Daft-Freak/32blit-hardware/pcb/kicad/LCDs_and_Power.kicad_sch

## KiCad design pcb/kicad/LCDs_and_Power.kicad_sch (2023-02-24)

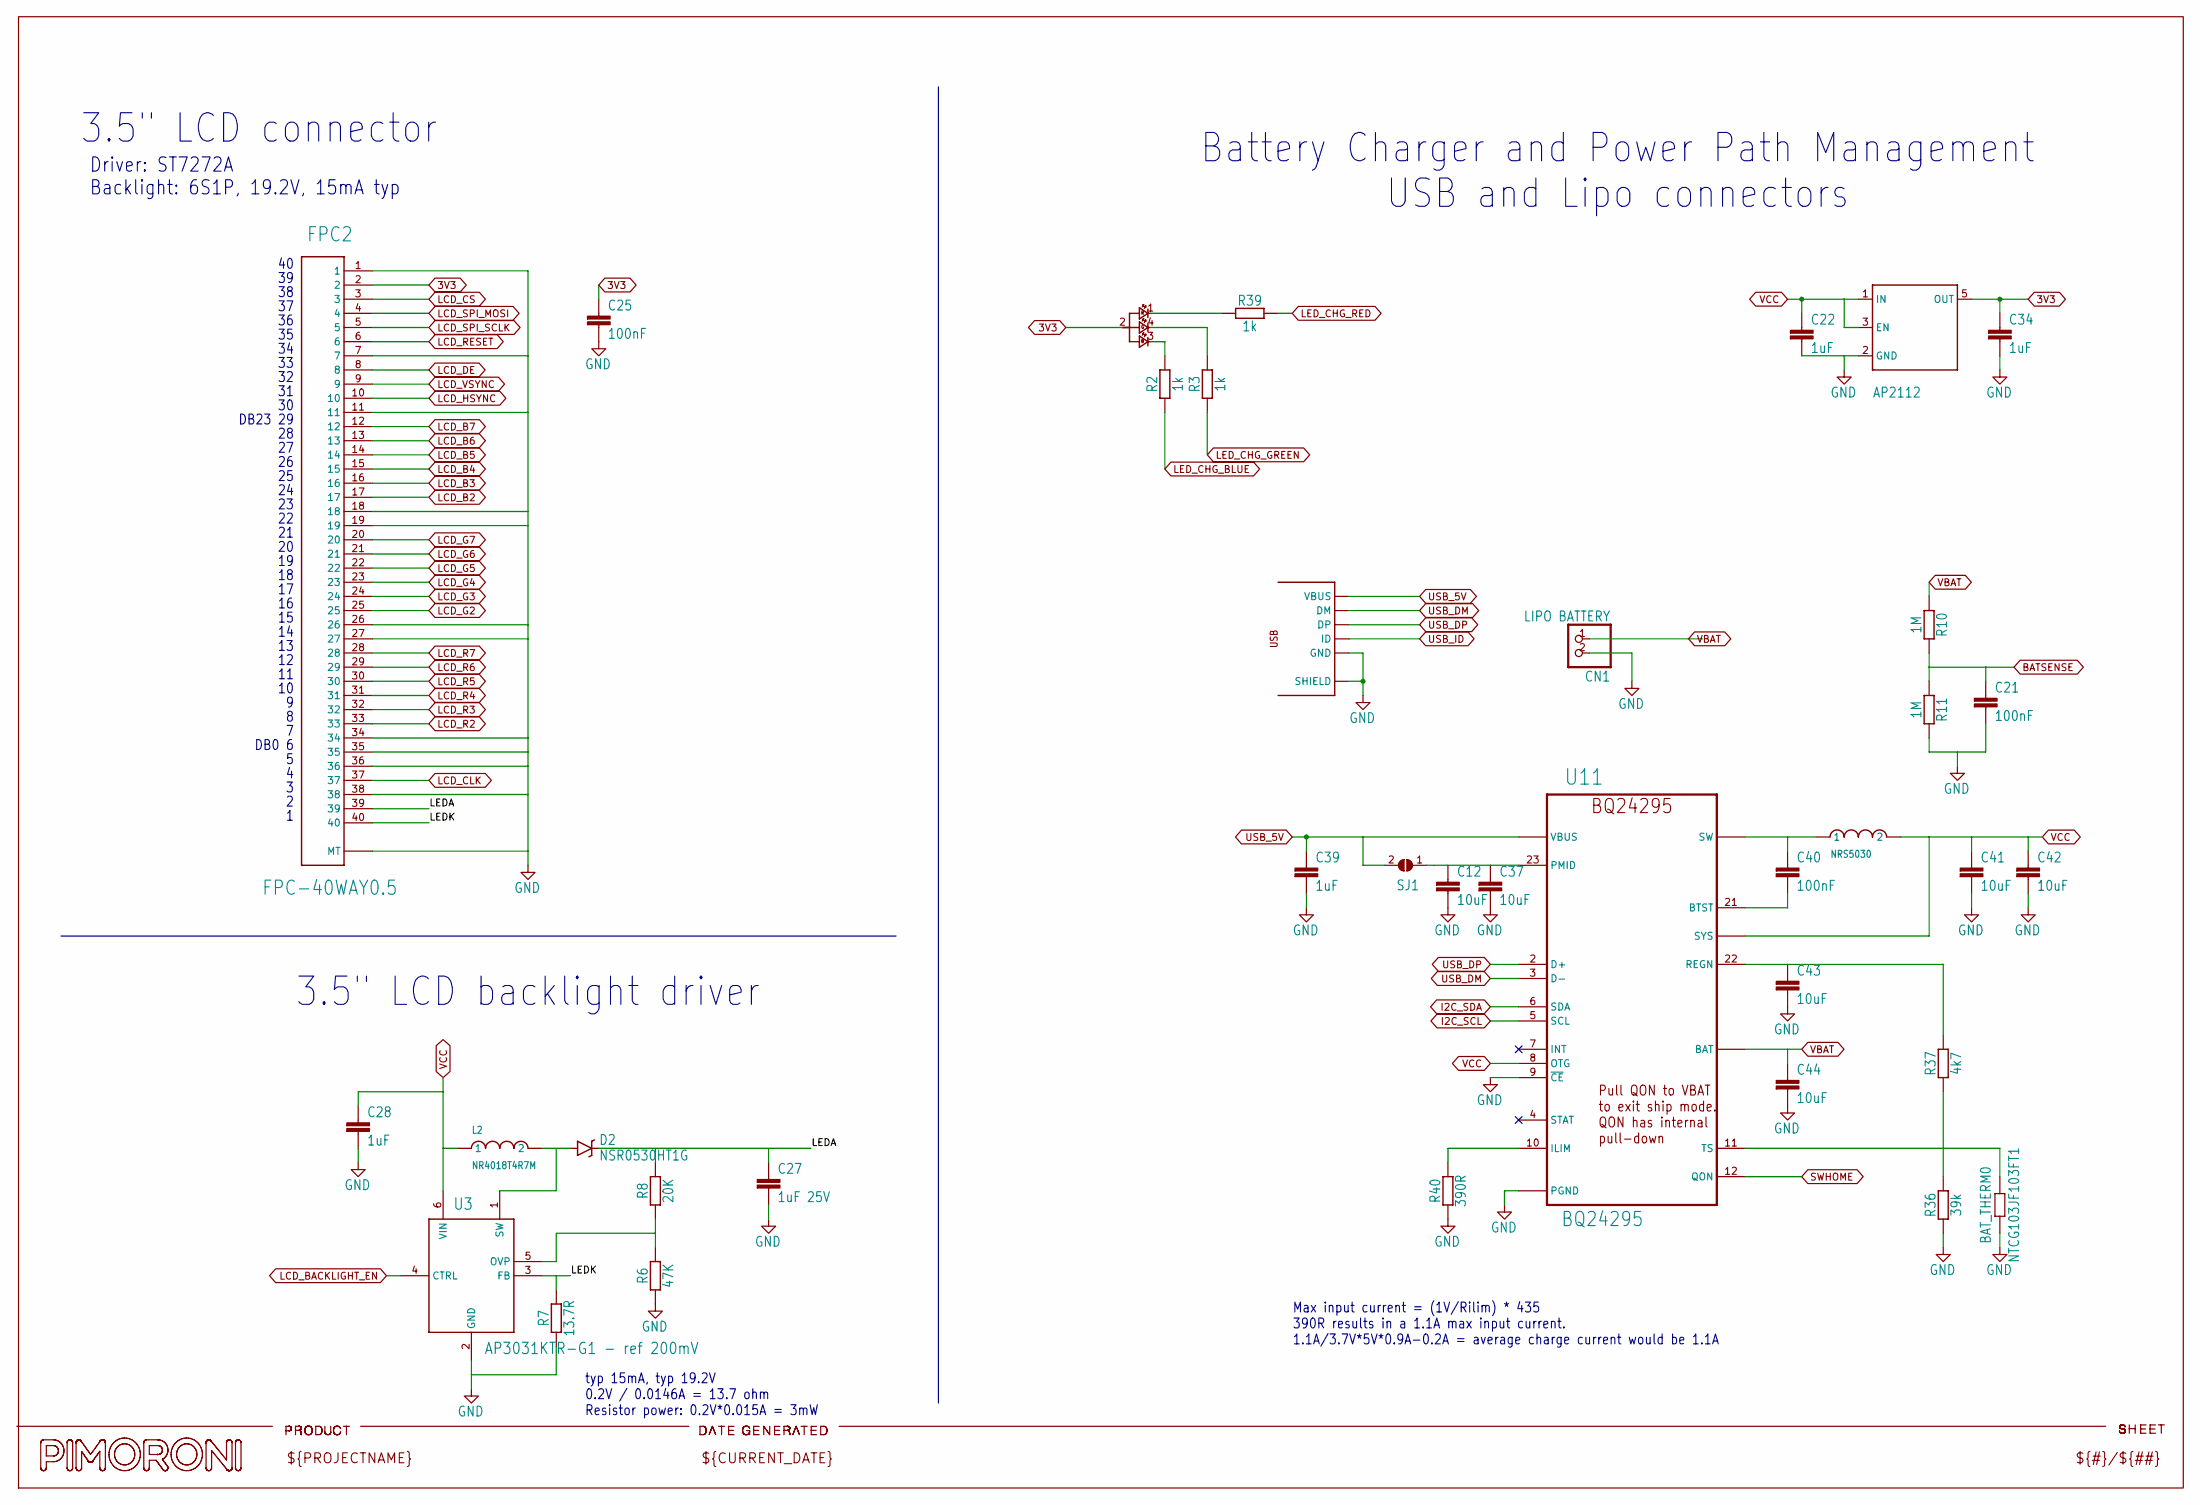
[picture p1: schematic LCDs_and_Power.kicad_sch]

Parts:
BAT_THERM0: NTCG103JF103FT1; 0402@1
C12, C37, C41, C42, C43, C44: 10uF; C0805
C21, C25, C40: 100nF; C0402K
C22, C28, C34, C39: 1uF; C0603
C27: 1uF 25V; C0603
CN1: LIPO BATTERY; JST-PH-2-SMT-RA
D2: NSR0530HT1G
FPC2: FPC-40WAY0.5; FPC-0.5MM-40WAY
L1: NRS5030
L2: NR4018T4R7M; NR4018
R2, R3, R39: 1k; R0603
R6: 47K; R0603
R7: 13.7R; R0603
R8: 20K; R0603
R10, R11: 1M; R0603
R36: 39k; R0603
R37: 4k7; R0603
R40: 390R; R0603
RGB1: LED_RGB_4P6028_REVERSE; LED-6028_REVERSE_RGB
SJ1: SOLDERJUMPER; SOLDERJUMPER_ARROW_NOPASTE
U3: AP3031KTR-G1 - ref 200mV; SOT23-6L
U6: AP2112; SOT-23-5
U11: BQ24295; QFN50P400X400X100-25N
U$3: USBMICROB; MICROB-USB

Connections:
3V3: C25.1, C34.1, FPC2.2, RGB1.2 (A), U6.5 (OUT)
BATSENSE: C21.1, R10.2, R11.1
GND: BAT_THERM0.1, C12.2, C21.2, C22.2, C25.2, C27.2, C28.2, C34.2, C37.2, C39.2, C41.2, C42.2, C43.2, C44.2, CN1.2 (1), FPC2.1, FPC2.7, FPC2.11, FPC2.18, FPC2.19, FPC2.26, FPC2.27, FPC2.34, FPC2.35, FPC2.36, FPC2.38, FPC2.MT1 (MT), FPC2.MT2 (MT), R6.1, R7.1, R11.2, R36.1, R40.1, U3.2 (GND), U6.2 (GND), U11.9 (~CE), U11.17 (PGND), U11.18 (PGND), U11.25 (PGND), U$3.GND, U$3.SH1 (SHIELD), U$3.SH2 (SHIELD), U$3.SH3 (SHIELD), U$3.SH4 (SHIELD), U$3.SH5 (SHIELD), U$3.SH6 (SHIELD), U$3.SH7 (SHIELD), U$3.SH8 (SHIELD)
I2C_SCL: U11.5 (SCL)
I2C_SDA: U11.6 (SDA)
LCD_B2: FPC2.17
LCD_B3: FPC2.16
LCD_B4: FPC2.15
LCD_B5: FPC2.14
LCD_B6: FPC2.13
LCD_B7: FPC2.12
LCD_BACKLIGHT_EN: U3.4 (CTRL)
LCD_CLK: FPC2.37
LCD_CS: FPC2.3
LCD_DE: FPC2.8
LCD_G2: FPC2.25
LCD_G3: FPC2.24
LCD_G4: FPC2.23
LCD_G5: FPC2.22
LCD_G6: FPC2.21
LCD_G7: FPC2.20
LCD_HSYNC: FPC2.10
LCD_R2: FPC2.33
LCD_R3: FPC2.32
LCD_R4: FPC2.31
LCD_R5: FPC2.30
LCD_R6: FPC2.29
LCD_R7: FPC2.28
LCD_RESET: FPC2.6
LCD_SPI_MOSI: FPC2.4
LCD_SPI_SCLK: FPC2.5
LCD_VSYNC: FPC2.9
LEDA: C27.1, D2.C, FPC2.39, R8.2
LEDK: FPC2.40, R7.2, U3.3 (FB)
LED_CHG_BLUE: R2.1
LED_CHG_GREEN: R3.1
LED_CHG_RED: R39.2
unnamed: BAT_THERM0.2, R36.2, R37.1, U11.11 (TS)
unnamed: C12.1, C37.1, SJ1.1 (A), U11.23 (PMID)
unnamed: C40.1, L1.1, U11.19 (SW), U11.20 (SW)
unnamed: C40.2, U11.21 (BTST)
unnamed: C43.1, R37.2, U11.22 (REGN)
unnamed: D2.A, L2.2, U3.1 (SW)
unnamed: R2.2, RGB1.3 (BC)
unnamed: R3.2, RGB1.4 (GC)
unnamed: R6.2, R8.1, U3.5 (OVP)
unnamed: R39.1, RGB1.1 (RC)
unnamed: R40.2, U11.10 (ILIM)
SWHOME: U11.12 (QON)
USB_5V: C39.1, SJ1.2 (B), U11.1 (VBUS), U11.24 (VBUS), U$3.VBUS
USB_DM: U11.3 (D-), U$3.DM
USB_DP: U11.2 (D+), U$3.DP
USB_ID: U$3.ID
VBAT: C44.1, CN1.1 (2), R10.1, U11.13 (BAT), U11.14 (BAT)
VCC: C22.1, C28.1, C41.1, C42.1, L1.2, L2.1, U3.6 (VIN), U6.1 (IN), U6.3 (EN), U11.8 (OTG), U11.15 (SYS), U11.16 (SYS)

Notes on the sheet:
3.5" LCD connector
typ 15mA, typ 19.2V 0.2V / 0.0146A = 13.7 ohm Resistor power: 0.2V*0.015A = 3mW
3.5" LCD backlight driver
DB0 6
Driver: ST7272A Backlight: 6S1P, 19.2V, 15mA typ
Battery Charger and Power Path Management USB and Lipo connectors
DB23 29
Max input current = (1V/Rilim) * 435 390R results in a 1.1A max input current. 1.1A/3.7V*5V*0.9A-0.2A = average charge current would be 1.1A
