Daft-Freak/32blit-hardware/pcb/kicad/MCU.kicad_sch

## KiCad design pcb/kicad/MCU.kicad_sch (2023-02-24)

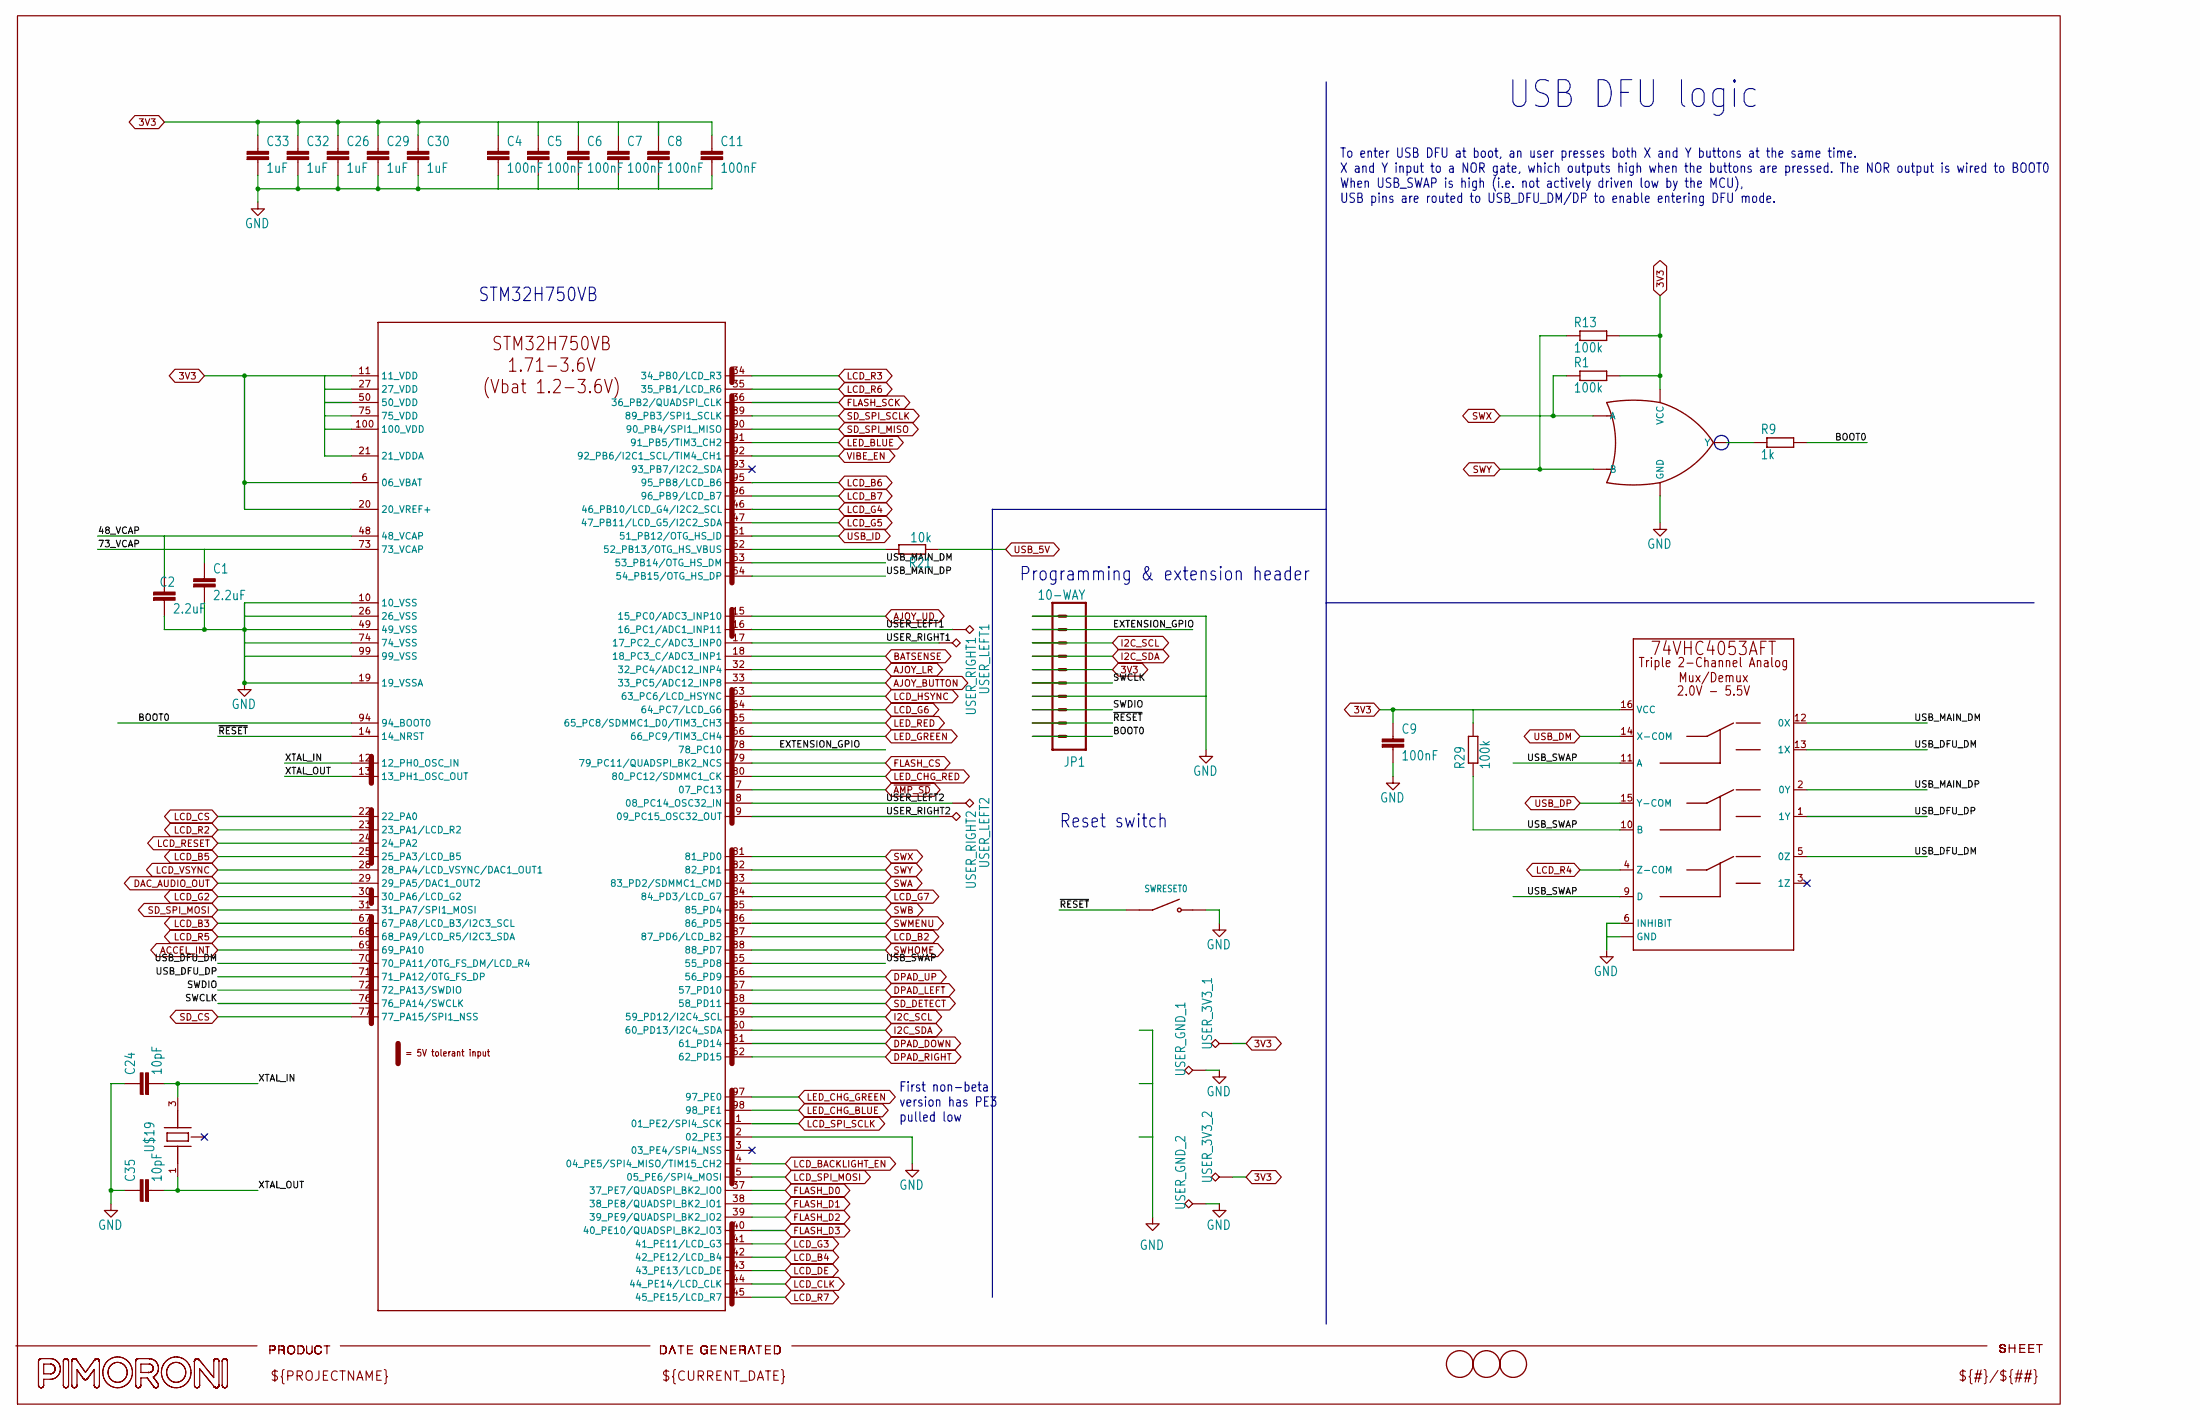
[picture p2: schematic MCU.kicad_sch]

Parts:
C1, C2: 2.2uF; C0603
C4, C5, C6, C7, C8, C9, C11: 100nF; C0402K
C24, C35: 10pF; C0603K
C26, C29, C30, C32, C33: 1uF; C0603
JP1: 10-WAY; 1X10_FEMALE_SMT_RIGHT_ANGLE
R1, R13, R29: 100k; R0603
R9: 1k; R0603
R21: 10k; R0603
STM32H750: STM32H750VB; LQFP-100
SWRESET0: LY-A03-02; TACT_RIGHT_ANGLE_LOW_PROFILE
U1: SN74AHC1G02; SOT-23-5
U8: 74VHC4053AFT; TSSOP-16-TI
U$17, U$22, U$23: FIDUCIAL1MM; FIDUCIAL-1MM
U$19: ABM8G-12.000MHZ-4Y-T3; TSX-3225
USER_3V3_1, USER_3V3_2: TPTP17SQ; TP17SQ
USER_GND_1, USER_GND_2: TPTP17SQ; TP17SQ
USER_LEFT1, USER_LEFT2: TPTP17SQ; TP17SQ
USER_RIGHT1, USER_RIGHT2: TPTP17SQ; TP17SQ

Connections:
3V3: C4.1, C5.1, C6.1, C7.1, C8.1, C9.1, C11.1, C26.1, C29.1, C30.1, C32.1, C33.1, JP1.A5 (5), JP1.B5 (5), R1.2, R13.2, R29.2, STM32H750.6 (06_VBAT), STM32H750.11 (11_VDD), STM32H750.20 (20_VREF+), STM32H750.21 (21_VDDA), STM32H750.27 (27_VDD), STM32H750.50 (50_VDD), STM32H750.75 (75_VDD), STM32H750.100 (100_VDD), U1.5 (VCC), U8.16 (VCC), USER_3V3_1.1, USER_3V3_2.1
48_VCAP: C2.1, STM32H750.48 (48_VCAP)
73_VCAP: C1.1, STM32H750.73 (73_VCAP)
ACCEL_INT: STM32H750.69 (69_PA10)
AJOY_BUTTON: STM32H750.33 (33_PC5/ADC12_INP8)
AJOY_LR: STM32H750.32 (32_PC4/ADC12_INP4)
AJOY_UD: STM32H750.15 (15_PC0/ADC3_INP10)
BATSENSE: STM32H750.18 (18_PC3_C/ADC3_INP1)
BOOT0: JP1.A10 (10), JP1.B10 (10), R9.2, STM32H750.94 (94_BOOT0)
DAC_AUDIO_OUT: STM32H750.29 (29_PA5/DAC1_OUT2)
DPAD_DOWN: STM32H750.61 (61_PD14)
DPAD_LEFT: STM32H750.57 (57_PD10)
DPAD_RIGHT: STM32H750.62 (62_PD15)
DPAD_UP: STM32H750.56 (56_PD9)
EXTENSION_GPIO: JP1.A2 (2), JP1.B2 (2), STM32H750.78 (78_PC10)
FLASH_CS: STM32H750.79 (79_PC11/QUADSPI_BK2_NCS)
FLASH_D0: STM32H750.37 (37_PE7/QUADSPI_BK2_IO0)
FLASH_D1: STM32H750.38 (38_PE8/QUADSPI_BK2_IO1)
FLASH_D2: STM32H750.39 (39_PE9/QUADSPI_BK2_IO2)
FLASH_D3: STM32H750.40 (40_PE10/QUADSPI_BK2_IO3)
FLASH_SCK: STM32H750.36 (36_PB2/QUADSPI_CLK)
GND: C1.2, C2.2, C4.2, C5.2, C6.2, C7.2, C8.2, C9.2, C11.2, C24.1, C26.2, C29.2, C30.2, C32.2, C33.2, C35.1, JP1.A1 (1), JP1.A7 (7), JP1.B1 (1), JP1.B7 (7), STM32H750.2 (02_PE3), STM32H750.10 (10_VSS), STM32H750.19 (19_VSSA), STM32H750.26 (26_VSS), STM32H750.49 (49_VSS), STM32H750.74 (74_VSS), STM32H750.99 (99_VSS), SWRESET0.3 (2), SWRESET0.4 (2), U1.3 (GND), U8.6 (INHIBIT), U8.7 (GND), U8.8 (GND), USER_GND_1.1, USER_GND_2.1
I2C_SCL: JP1.A3 (3), JP1.B3 (3), STM32H750.59 (59_PD12/I2C4_SCL)
I2C_SDA: JP1.A4 (4), JP1.B4 (4), STM32H750.60 (60_PD13/I2C4_SDA)
LCD_B2: STM32H750.87 (87_PD6/LCD_B2)
LCD_B3: STM32H750.67 (67_PA8/LCD_B3/I2C3_SCL)
LCD_B4: STM32H750.42 (42_PE12/LCD_B4)
LCD_B5: STM32H750.25 (25_PA3/LCD_B5)
LCD_B6: STM32H750.95 (95_PB8/LCD_B6)
LCD_B7: STM32H750.96 (96_PB9/LCD_B7)
LCD_BACKLIGHT_EN: STM32H750.4 (04_PE5/SPI4_MISO/TIM15_CH2)
LCD_CLK: STM32H750.44 (44_PE14/LCD_CLK)
LCD_CS: STM32H750.22 (22_PA0)
LCD_DE: STM32H750.43 (43_PE13/LCD_DE)
LCD_G2: STM32H750.30 (30_PA6/LCD_G2)
LCD_G3: STM32H750.41 (41_PE11/LCD_G3)
LCD_G4: STM32H750.46 (46_PB10/LCD_G4/I2C2_SCL)
LCD_G5: STM32H750.47 (47_PB11/LCD_G5/I2C2_SDA)
LCD_G6: STM32H750.64 (64_PC7/LCD_G6)
LCD_G7: STM32H750.84 (84_PD3/LCD_G7)
LCD_HSYNC: STM32H750.63 (63_PC6/LCD_HSYNC)
LCD_R2: STM32H750.23 (23_PA1/LCD_R2)
LCD_R3: STM32H750.34 (34_PB0/LCD_R3)
LCD_R4: U8.4 (Z-COM)
LCD_R5: STM32H750.68 (68_PA9/LCD_R5/I2C3_SDA)
LCD_R6: STM32H750.35 (35_PB1/LCD_R6)
LCD_R7: STM32H750.45 (45_PE15/LCD_R7)
LCD_RESET: STM32H750.24 (24_PA2)
LCD_SPI_MOSI: STM32H750.5 (05_PE6/SPI4_MOSI)
LCD_SPI_SCLK: STM32H750.1 (01_PE2/SPI4_SCK)
LCD_VSYNC: STM32H750.28 (28_PA4/LCD_VSYNC/DAC1_OUT1)
LED_BLUE: STM32H750.91 (91_PB5/TIM3_CH2)
LED_CHG_BLUE: STM32H750.98 (98_PE1)
LED_CHG_GREEN: STM32H750.97 (97_PE0)
LED_CHG_RED: STM32H750.80 (80_PC12/SDMMC1_CK)
LED_GREEN: STM32H750.66 (66_PC9/TIM3_CH4)
LED_RED: STM32H750.65 (65_PC8/SDMMC1_D0/TIM3_CH3)
unnamed: R9.1, U1.4 (Y)
unnamed: R21.2, STM32H750.52 (52_PB13/OTG_HS_VBUS)
unnamed: U$19.2 (GND), U$19.4 (GND)
SD_CS: STM32H750.77 (77_PA15/SPI1_NSS)
SD_DETECT: STM32H750.58 (58_PD11)
SD_SPI_MISO: STM32H750.90 (90_PB4/SPI1_MISO)
SD_SPI_MOSI: STM32H750.31 (31_PA7/SPI1_MOSI)
SD_SPI_SCLK: STM32H750.89 (89_PB3/SPI1_SCLK)
SWA: STM32H750.83 (83_PD2/SDMMC1_CMD)
SWB: STM32H750.85 (85_PD4)
SWCLK: JP1.A6 (6), JP1.B6 (6), STM32H750.76 (76_PA14/SWCLK)
SWDIO: JP1.A8 (8), JP1.B8 (8), STM32H750.72 (72_PA13/SWDIO)
SWHOME: STM32H750.88 (88_PD7)
SWMENU: STM32H750.86 (86_PD5)
SWX: R1.1, STM32H750.81 (81_PD0), U1.1 (A)
SWY: R13.1, STM32H750.82 (82_PD1), U1.2 (B)
USB_5V: R21.1
USB_DFU_DM: STM32H750.70 (70_PA11/OTG_FS_DM/LCD_R4), U8.5 (0Z), U8.13 (1X)
USB_DFU_DP: STM32H750.71 (71_PA12/OTG_FS_DP), U8.1 (1Y)
USB_DM: U8.14 (X-COM)
USB_DP: U8.15 (Y-COM)
USB_ID: STM32H750.51 (51_PB12/OTG_HS_ID)
USB_MAIN_DM: STM32H750.53 (53_PB14/OTG_HS_DM), U8.12 (0X)
USB_MAIN_DP: STM32H750.54 (54_PB15/OTG_HS_DP), U8.2 (0Y)
USB_SWAP: R29.1, STM32H750.55 (55_PD8), U8.9 (D), U8.10 (B), U8.11 (A)
USER_LEFT1: STM32H750.16 (16_PC1/ADC1_INP11), USER_LEFT1.1
USER_LEFT2: STM32H750.8 (08_PC14_OSC32_IN), USER_LEFT2.1
USER_RIGHT1: STM32H750.17 (17_PC2_C/ADC3_INP0), USER_RIGHT1.1
USER_RIGHT2: STM32H750.9 (09_PC15_OSC32_OUT), USER_RIGHT2.1
VIBE_EN: STM32H750.92 (92_PB6/I2C1_SCL/TIM4_CH1)
XTAL_IN: C24.2, STM32H750.12 (12_PH0_OSC_IN), U$19.3 (2)
XTAL_OUT: C35.2, STM32H750.13 (13_PH1_OSC_OUT), U$19.1
~AMP_SD: STM32H750.7 (07_PC13)
~RESET: JP1.A9 (9), JP1.B9 (9), STM32H750.14 (14_NRST), SWRESET0.1, SWRESET0.2 (1)

Notes on the sheet:
First non-beta version has PE3 pulled low
STM32H750VB
Programming & extension header
Reset switch
To enter USB DFU at boot, an user presses both X and Y buttons at the same time. X and Y input to a NOR gate, which outputs high when the buttons are pressed. The NOR output is wired to BOOT0 When USB_SWAP is high (i.e. not actively driven low by the MCU), USB pins are routed to USB_DFU_DM/DP to en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
USB DFU logic
