Daft-Freak/32blit-hardware/pcb/kicad/Peripherals.kicad_sch

## KiCad design pcb/kicad/Peripherals.kicad_sch (2023-02-24)

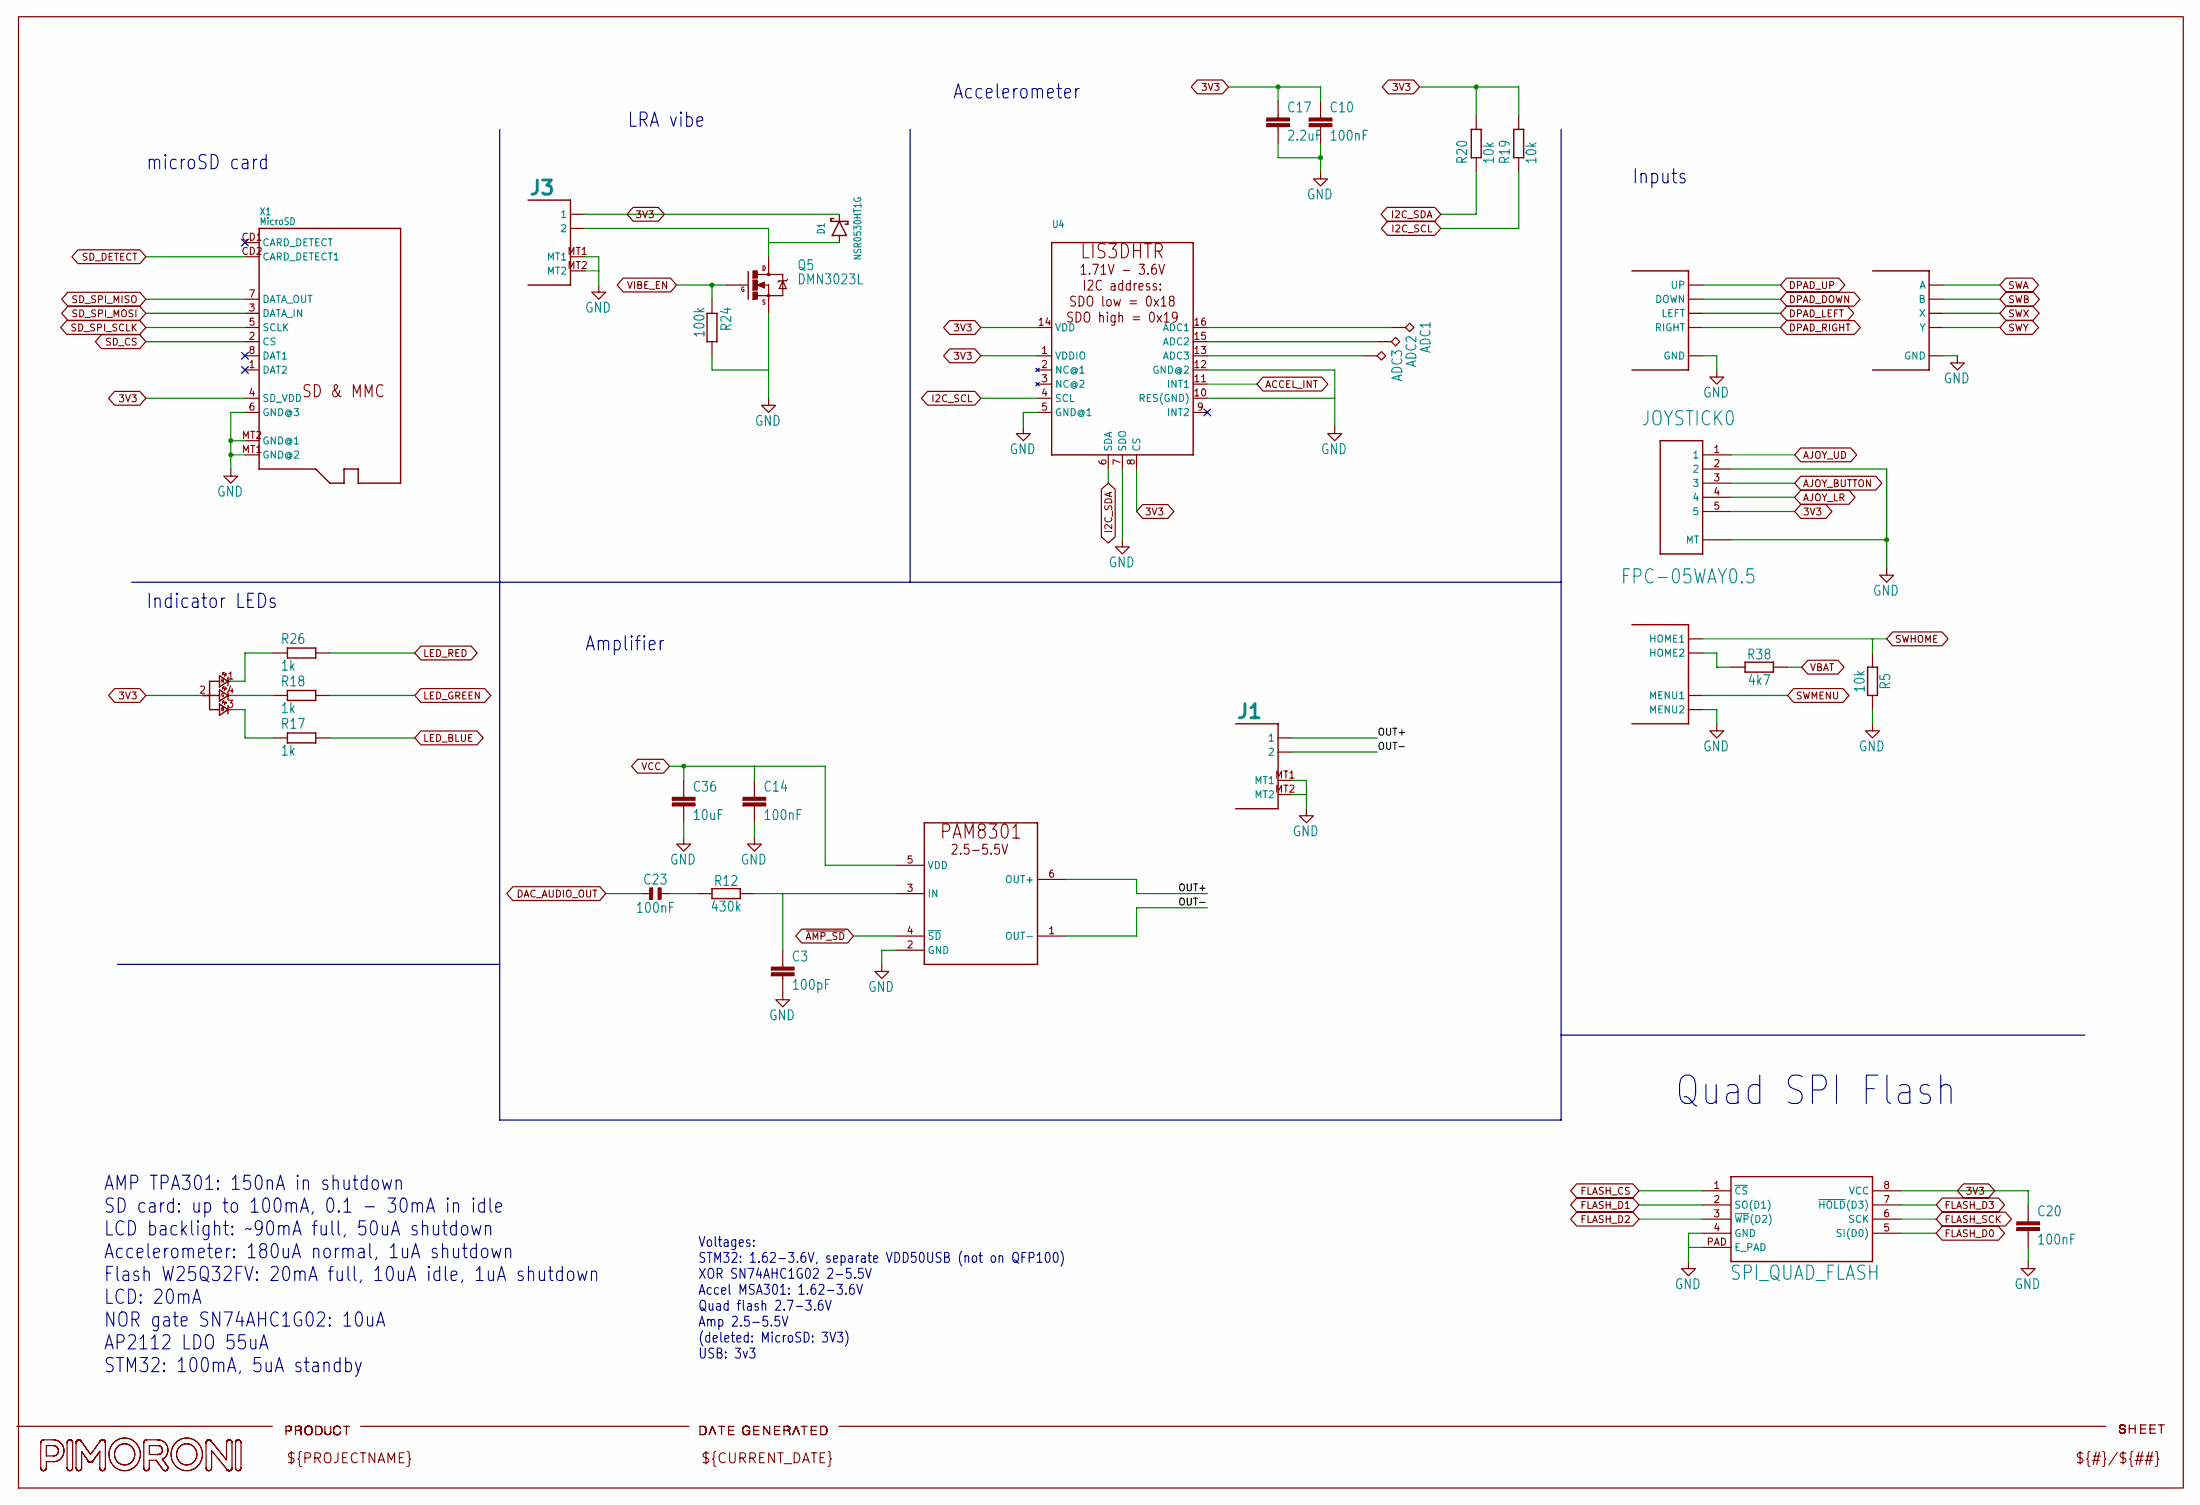
[picture p3: schematic Peripherals.kicad_sch]

Parts:
ABXY0: ABXY
ADC1, ADC2, ADC3: TPTP17SQ; TP17SQ
C3: 100pF; C0603
C10, C14, C20: 100nF; C0402K
C17: 2.2uF; C0603
C23: 100nF; 0402
C36: 10uF; C0805
D1: NSR0530HT1G; SOD-323
DPAD0: DPAD
J1: 1X02PICOBLADE; PICOBLADE_1.25MM_2P
J3: 1X02JST_SH; JST_SH_1.0MM_2P
JOYSTICK0: FPC-05WAY0.5; FPC-0.5MM-05WAY
Q5: DMN3023L; SOT23
R5, R19, R20: 10k; R0603
R12: 430k; R0603
R17, R18, R26: 1k; R0603
R24: 100k; R0603
R38: 4k7; R0603
RGB2: LED_RGB_4P6028_REVERSE; LED-6028_REVERSE_RGB
U4: ACCEL_LIS3DHTR; LGA16_3X3MM
U5: PAM8301; SOT-23-6
U22: SPI_QUAD_FLASH; DFN-8_6X5MM
U$18: HOME-MENU; MENU-HOME
X1: MicroSD; MICROSD

Connections:
3V3: C10.1, C17.1, C20.1, D1.C, J3.1, JOYSTICK0.5, R19.2, R20.2, RGB2.2 (A), U4.1 (VDDIO), U4.8 (CS), U4.14 (VDD), U22.8 (VCC), X1.4 (SD_VDD)
ACCEL_INT: U4.11 (INT1)
AJOY_BUTTON: JOYSTICK0.3
AJOY_LR: JOYSTICK0.4
AJOY_UD: JOYSTICK0.1
DAC_AUDIO_OUT: C23.2
DPAD_DOWN: DPAD0.DOWN
DPAD_LEFT: DPAD0.LEFT
DPAD_RIGHT: DPAD0.RIGHT
DPAD_UP: DPAD0.UP
FLASH_CS: U22.1 (~CS)
FLASH_D0: U22.5 (SI(D0))
FLASH_D1: U22.2 (SO(D1))
FLASH_D2: U22.3 (~WP(D2))
FLASH_D3: U22.7 (~HOLD(D3))
FLASH_SCK: U22.6 (SCK)
GND: ABXY0.GND1 (GND), ABXY0.GND2 (GND), ABXY0.GND3 (GND), ABXY0.GND4 (GND), C3.2, C10.2, C14.2, C17.2, C20.2, C36.2, DPAD0.GND1 (GND), DPAD0.GND2 (GND), DPAD0.GND3 (GND), DPAD0.GND4 (GND), J1.MT1, J1.MT2, J3.MT1, J3.MT2, JOYSTICK0.2, JOYSTICK0.MT1 (MT), JOYSTICK0.MT2 (MT), Q5.2 (S), R5.2, R24.2, U4.5 (GND@1), U4.7 (SDO), U4.10 (RES(GND)), U4.12 (GND@2), U5.2 (GND), U22.4 (GND), U22.PAD (E_PAD), U$18.GND3 (MENU2), X1.6 (GND@3), X1.MT1 (GND@2), X1.MT2 (GND@1)
I2C_SCL: R19.1, U4.4 (SCL)
I2C_SDA: R20.1, U4.6 (SDA)
LED_BLUE: R17.2
LED_GREEN: R18.2
LED_RED: R26.2
unnamed: ADC1.1, U4.16 (ADC1)
unnamed: ADC2.1, U4.15 (ADC2)
unnamed: ADC3.1, U4.13 (ADC3)
unnamed: C3.1, R12.2, U5.3 (IN)
unnamed: C23.1, R12.1
unnamed: D1.A, J3.2, Q5.3 (D)
unnamed: R17.1, RGB2.3 (BC)
unnamed: R18.1, RGB2.4 (GC)
unnamed: R26.1, RGB2.1 (RC)
unnamed: R38.1, U$18.GND4 (HOME2)
OUT+: J1.1, U5.6 (OUT+)
OUT-: J1.2, U5.1 (OUT-)
SD_CS: X1.2 (CS)
SD_DETECT: X1.CD2 (CARD_DETECT1)
SD_SPI_MISO: X1.7 (DATA_OUT)
SD_SPI_MOSI: X1.3 (DATA_IN)
SD_SPI_SCLK: X1.5 (SCLK)
SWA: ABXY0.A
SWB: ABXY0.B
SWHOME: R5.1, U$18.HOME (HOME1)
SWMENU: U$18.MENU (MENU1)
SWX: ABXY0.X
SWY: ABXY0.Y
VBAT: R38.2
VCC: C14.1, C36.1, U5.5 (VDD)
VIBE_EN: Q5.1 (G), R24.1
~AMP_SD: U5.4 (~SD)

Notes on the sheet:
Quad SPI Flash
Amplifier
Accelerometer
Indicator LEDs
Voltages: STM32: 1.62-3.6V, separate VDD50USB (not on QFP100) XOR SN74AHC1G02 2-5.5V Accel MSA301: 1.62-3.6V Quad flash 2.7-3.6V Amp 2.5-5.5V (deleted: MicroSD: 3V3) USB: 3v3
AMP TPA301: 150nA in shutdown SD card: up to 100mA, 0.1 - 30mA in idle LCD backlight: ~90mA full, 50uA shutdown Accelerometer: 180uA normal, 1uA shutdown Flash W25Q32FV: 20mA full, 10uA idle, 1uA shutdown LCD: 20mA NOR gate SN74AHC1G02: 10uA AP2112 LDO 55uA STM32: 100mA, 5uA standby
LRA vibe
microSD card
Inputs
